L71/1LFO/README.md

1LFO
====

Simple Eurorack LFO with triangle wave outputs. 

V2 replaces inverted triangle output with square wave output and adds a frequency range switch.
Both versions have been built and works well.
