L71/1LFO/1LFO_v2.brd

## EAGLE design 1LFO_v2.brd (2015-10-24)

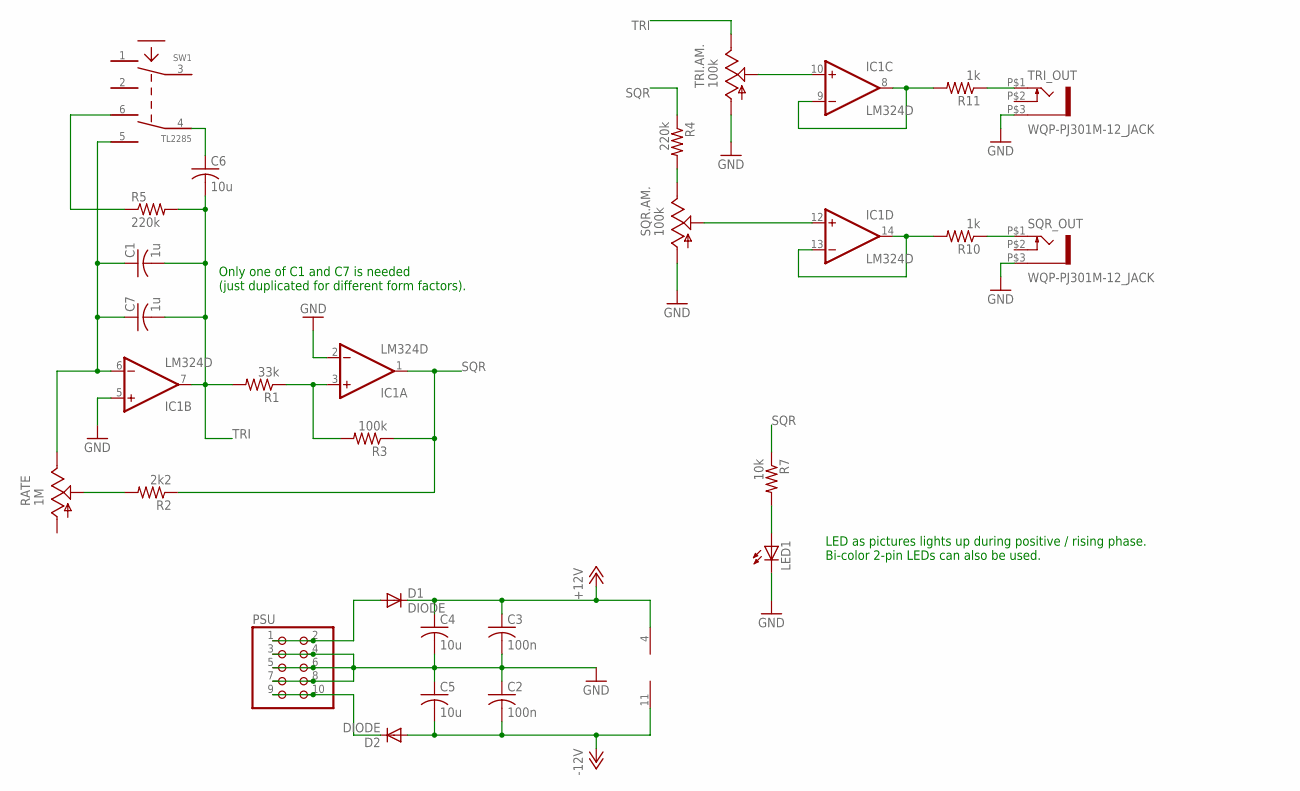
[picture p1: schematic 1LFO_v2.sch]

Parts:
C1: 1u; C1206K
C2, C3: 100n; C0603K
C4, C5, C6: 10u; C1206K
C7: 1u; C0603K
D1, D2: DIODE; DO214AA
IC1: LM324D; SO14
LED1: LED5MM
PSU: PINHD-2X5; 2X05
R1: 33k; R0603
R2: 2k2; R0603
R3: 100k; R0603
R4, R5: 220k; R0603
R7: 10k; R0603
R10, R11: 1k; R0603
RATE: 1M; ALPS_POT_VERTICAL
SQR.AM.: 100k; ALPS_POT_VERTICAL
SQR_OUT: WQP-PJ301M-12_JACK
SW1: TL2285; TL2285_PCB
TRI.AM.: 100k; ALPS_POT_VERTICAL
TRI_OUT: WQP-PJ301M-12_JACK

Connections:
+12V: C3.1, C4.1, D1.C, IC1.4 (V+)
-12V: C2.2, C5.2, D2.A, IC1.11 (V-)
GND: C2.1, C3.2, C4.2, C5.1, IC1.2 (-IN), IC1.5 (+IN), LED1.K (C), PSU.3, PSU.4, PSU.5, PSU.6, PSU.7, PSU.8, SQR.AM..P$3 (A), SQR_OUT.P$3 (1), TRI.AM..P$3 (A), TRI_OUT.P$3 (1)
unnamed: C1.1, C7.1, IC1.6 (-IN), RATE.P$1 (E), SW1.5
unnamed: IC1.12 (+IN), SQR.AM..P$2 (S)
unnamed: R4.2, SQR.AM..P$1 (E)
unnamed: C6.1, SW1.4
unnamed: IC1.3 (+IN), R1.1, R3.2
unnamed: R5.1, SW1.6
unnamed: R2.2, RATE.P$2 (S)
unnamed: IC1.8 (OUT), IC1.9 (-IN), R11.2
unnamed: IC1.10 (+IN), TRI.AM..P$2 (S)
unnamed: D1.A, PSU.1, PSU.2
unnamed: D2.C, PSU.9, PSU.10
unnamed: LED1.A, R7.2
unnamed: IC1.13 (-IN), IC1.14 (OUT), R10.2
unnamed: R11.1, TRI_OUT.P$1 (2)
unnamed: R10.1, SQR_OUT.P$1 (2)
SQR: IC1.1 (OUT), R2.1, R3.1, R4.1, R7.1
TRI: C1.2, C6.2, C7.2, IC1.7 (OUT), R1.2, R5.2, TRI.AM..P$1 (E)

Notes on the sheet:
Only one of C1 and C7 is needed (just duplicated for different form factors).
LED as pictures lights up during positive / rising phase. Bi-color 2-pin LEDs can also be used.

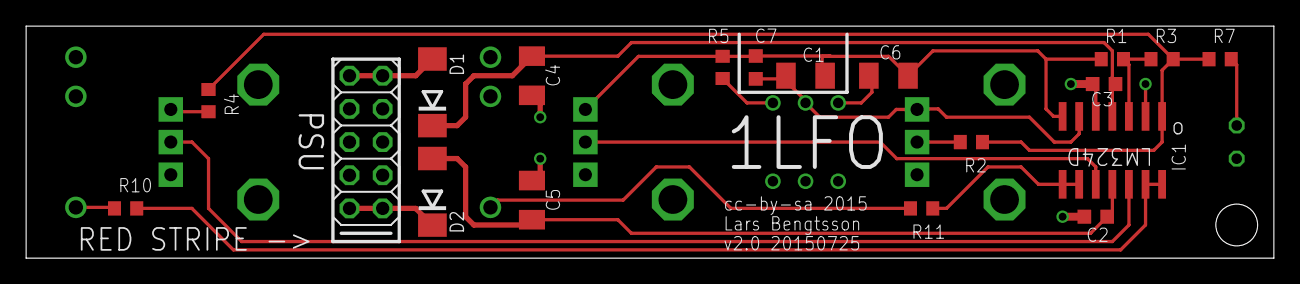
[picture p2: board 1LFO_v2.brd from above]

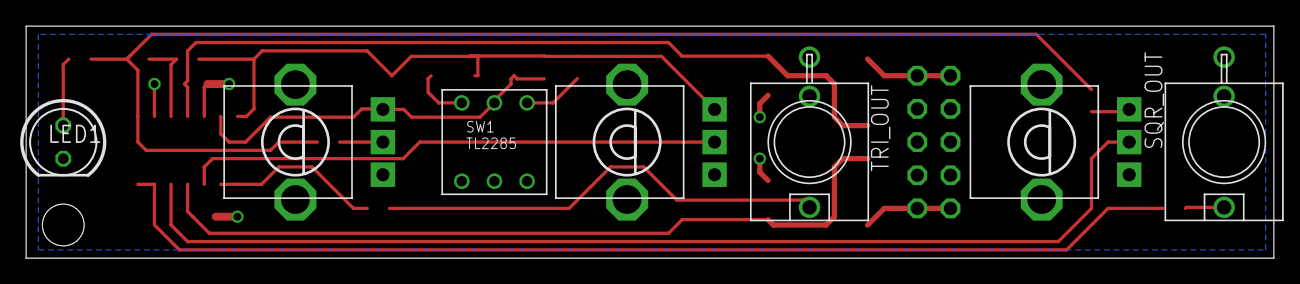
[picture p3: board 1LFO_v2.brd from below]

Board: 2 copper layers, 95.6 x 17.8 mm, 26 parts (7 on the bottom side), 20 nets.
