L71/1LFO/1LFO.brd

## EAGLE design 1LFO.brd (2015-06-15, an earlier design)

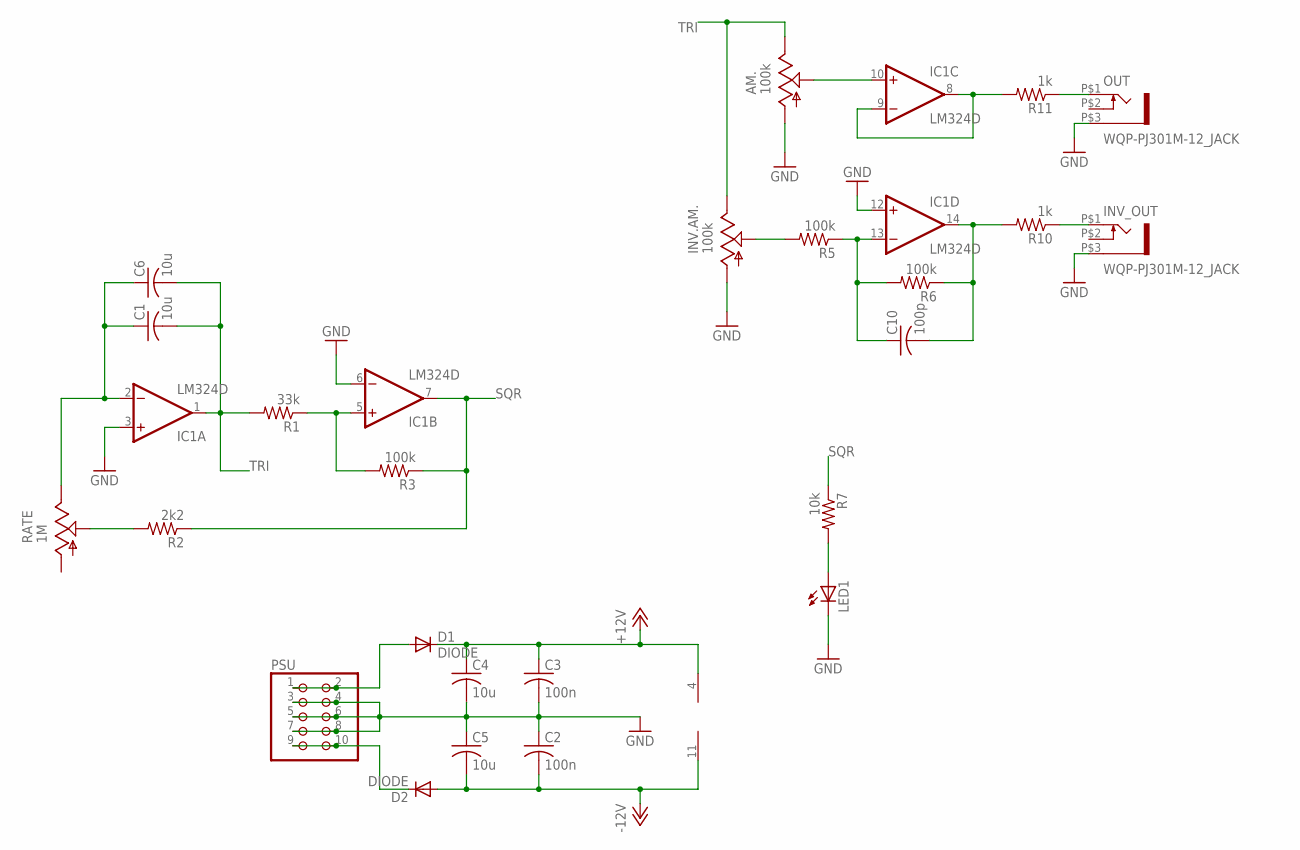
[picture p4: schematic 1LFO.sch]

Parts:
AM.: 100k; ALPS_POT_VERTICAL
C1, C4, C5: 10u; C1206K
C2, C3: 100n; C0603K
C6: 10u; C0603K
C10: 100p; C0603K
D1, D2: DIODE; DO214AA
IC1: LM324D; SO14
INV.AM.: 100k; ALPS_POT_VERTICAL
INV_OUT: WQP-PJ301M-12_JACK
LED1: LED3MM
OUT: WQP-PJ301M-12_JACK
PSU: PINHD-2X5; 2X05
R1: 33k; R0603
R2: 2k2; R0603
R3, R5, R6: 100k; R0603
R7: 10k; R0603
R10, R11: 1k; R0603
RATE: 1M; ALPS_POT_VERTICAL

Connections:
+12V: C3.1, C4.1, D1.C, IC1.4 (V+)
-12V: C2.2, C5.2, D2.A, IC1.11 (V-)
GND: AM..P$3 (A), C2.1, C3.2, C4.2, C5.1, IC1.3 (+IN), IC1.6 (-IN), IC1.12 (+IN), INV.AM..P$3 (A), INV_OUT.P$3 (1), LED1.K (C), OUT.P$3 (1), PSU.3, PSU.4, PSU.5, PSU.6, PSU.7, PSU.8
unnamed: C1.1, C6.1, IC1.2 (-IN), RATE.P$1 (E)
unnamed: INV.AM..P$2 (S), R5.2
unnamed: IC1.5 (+IN), R1.1, R3.2
unnamed: R2.2, RATE.P$2 (S)
unnamed: IC1.8 (OUT), IC1.9 (-IN), R11.2
unnamed: AM..P$2 (S), IC1.10 (+IN)
unnamed: D1.A, PSU.1, PSU.2
unnamed: D2.C, PSU.9, PSU.10
unnamed: C10.1, IC1.13 (-IN), R5.1, R6.2
unnamed: LED1.A, R7.2
unnamed: C10.2, IC1.14 (OUT), R6.1, R10.2
unnamed: OUT.P$1 (2), R11.1
unnamed: INV_OUT.P$1 (2), R10.1
SQR: IC1.7 (OUT), R2.1, R3.1, R7.1
TRI: AM..P$1 (E), C1.2, C6.2, IC1.1 (OUT), INV.AM..P$1 (E), R1.2

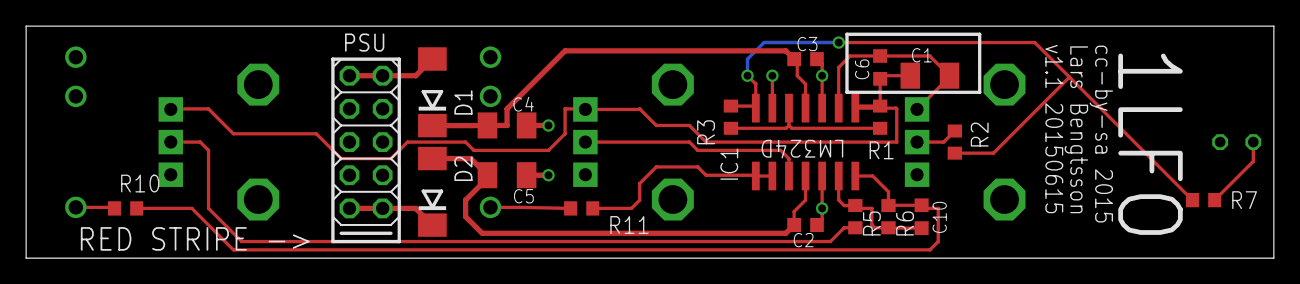
[picture p5: board 1LFO.brd from above]

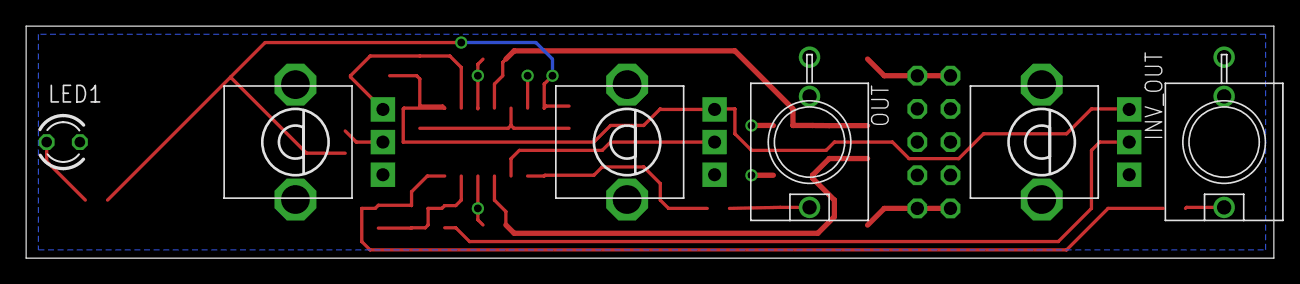
[picture p6: board 1LFO.brd from below]

Board: 2 copper layers, 95.6 x 17.8 mm, 25 parts (6 on the bottom side), 18 nets.
