L71/1LFO/(commit log)

2015-06-06 Initial commit.
    [1LFO.brd, 1LFO.sch]
2015-06-15 Use 3mm LED package (fits on board, panel still has 5mm hole).
    [1LFO.sch]
2015-06-15 Moved LED 2.54mm up, fits panel now (originally a mistake, but panel looks fine now. Better fix board). Also, size down other end of PCB to save a few cents on manufacturing.
    [1LFO.brd]
2015-06-15 Removed C7. Moved remaining timing caps a bit and changed value to the right one (10uF). Only one of C1 and C6 needs to be fitted. 10uF caps are easier to find in 1206 packages with higher voltage to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
    [1LFO.brd, 1LFO.sch]
2015-07-25 Initial commit of v2 with square wave output too.
    [1LFO_v2.brd, 1LFO_v2.sch]
2015-07-25 Added button hole.
2015-07-25 Added switch to select LFO rate range. Moved IC1 & rerouted to make room for the same.
    [1LFO_v2.brd, 1LFO_v2.sch]
2015-07-25 Minor routing polish :)
    [1LFO_v2.brd]
2015-07-25 Set lines to 0.01mm, added line between rate knob and button.
2015-10-24 Added hole for support spacer, may be needed if weak panel is used and the rate potentiometer can't be fixed to it.
    [1LFO_v2.brd]
2016-01-11 Adjusted panel size and bottom hole downwards 1/40" to hopefully fit racks w 3mm screws.
