L71/1LFO/(notices)

Notices in the files:
1LFO_v2.brd:
cc-by-sa 2015
